Castle10K/KiCad_PCB/AI_chat/GPIO핀_리스트업.md

# GPIO 핀 정리

## Makerfabs esp32uwb dw3000보드 GPIO핀 정리

 * **강하게 피하기:**
  
   4, 6, 7, 8, 9, 10, 11, 16, 17, 18, 19, 23, 27, 34
 * **부팅문제 때문에 가급적 피하기:**
  
   2, 5, 12, 15

 * **입력으로만 사용:**
  
   34, 35, 36, 39

## 추천 핀

**13, 14, 21, 22, 25, 26, 32, 33**
