Castle10K/KiCad_PCB/AI_chat/PCB_제작_순서정리.md

# PCB 제작 순서

### 최초 PCB 제작해봄

---

ESP32에 연결되는 신호, 데이터선을 모두 정해놓은 다음 구리선 배치함.

배치하고 라우팅 하다보니 선이 너무 꼬여서 배치가 거의 불가능함.

신호 간섭과 EMI 등을 고려해 모듈들 배치를 완료한 다음 센서 등에서 최대한 짧게 메인MCU에 연결되는 방식이면 참 좋겠다는 생각이 들었다.

그래서 GPT랑 같이 정리한 결과를 아래 작성

---

### 제작 순서

1. ESP32에서 사용 금지/주의 핀 먼저 제외
2. 남은 안전한 GPIO에 임시 할당
3. ERC 검사
4. 풋프린트 할당
5. PCB로 업데이트
6. 부품 배치만 먼저 진행
7. RATSNEST 선이 꼬이는 부분 확인 -> 연결 지시선인 얇은 파란선 (가연결선 같이 생김)
8. 바꿔도 되는 GPIO/커넥터 핀맵 검토
9. 회로도 편집기로 돌아가 연결 수정
10. PCB 업데이트
11. 다시 배치 확인
12. 거의 확정되면 라우팅 시작

---

## 특히, 6번에서 바로 라우팅 하지 않는게 좋다

커넥터 핀 번호는 실제 꽂는 방향 기준으로 문서화 하는게 좋다.
