Castle10K/KiCad_PCB/UWB_ESP32S3_MainBoard_v2/UWB_ESP32S3_MainBoard_v2/UWB_ESP32S3_MainBoard_v2.kicad_pcb

## KiCad design UWB_ESP32S3_MainBoard_v2/UWB_ESP32S3_MainBoard_v2/UWB_ESP32S3_MainBoard_v2.kicad_pcb (2026-08-06)

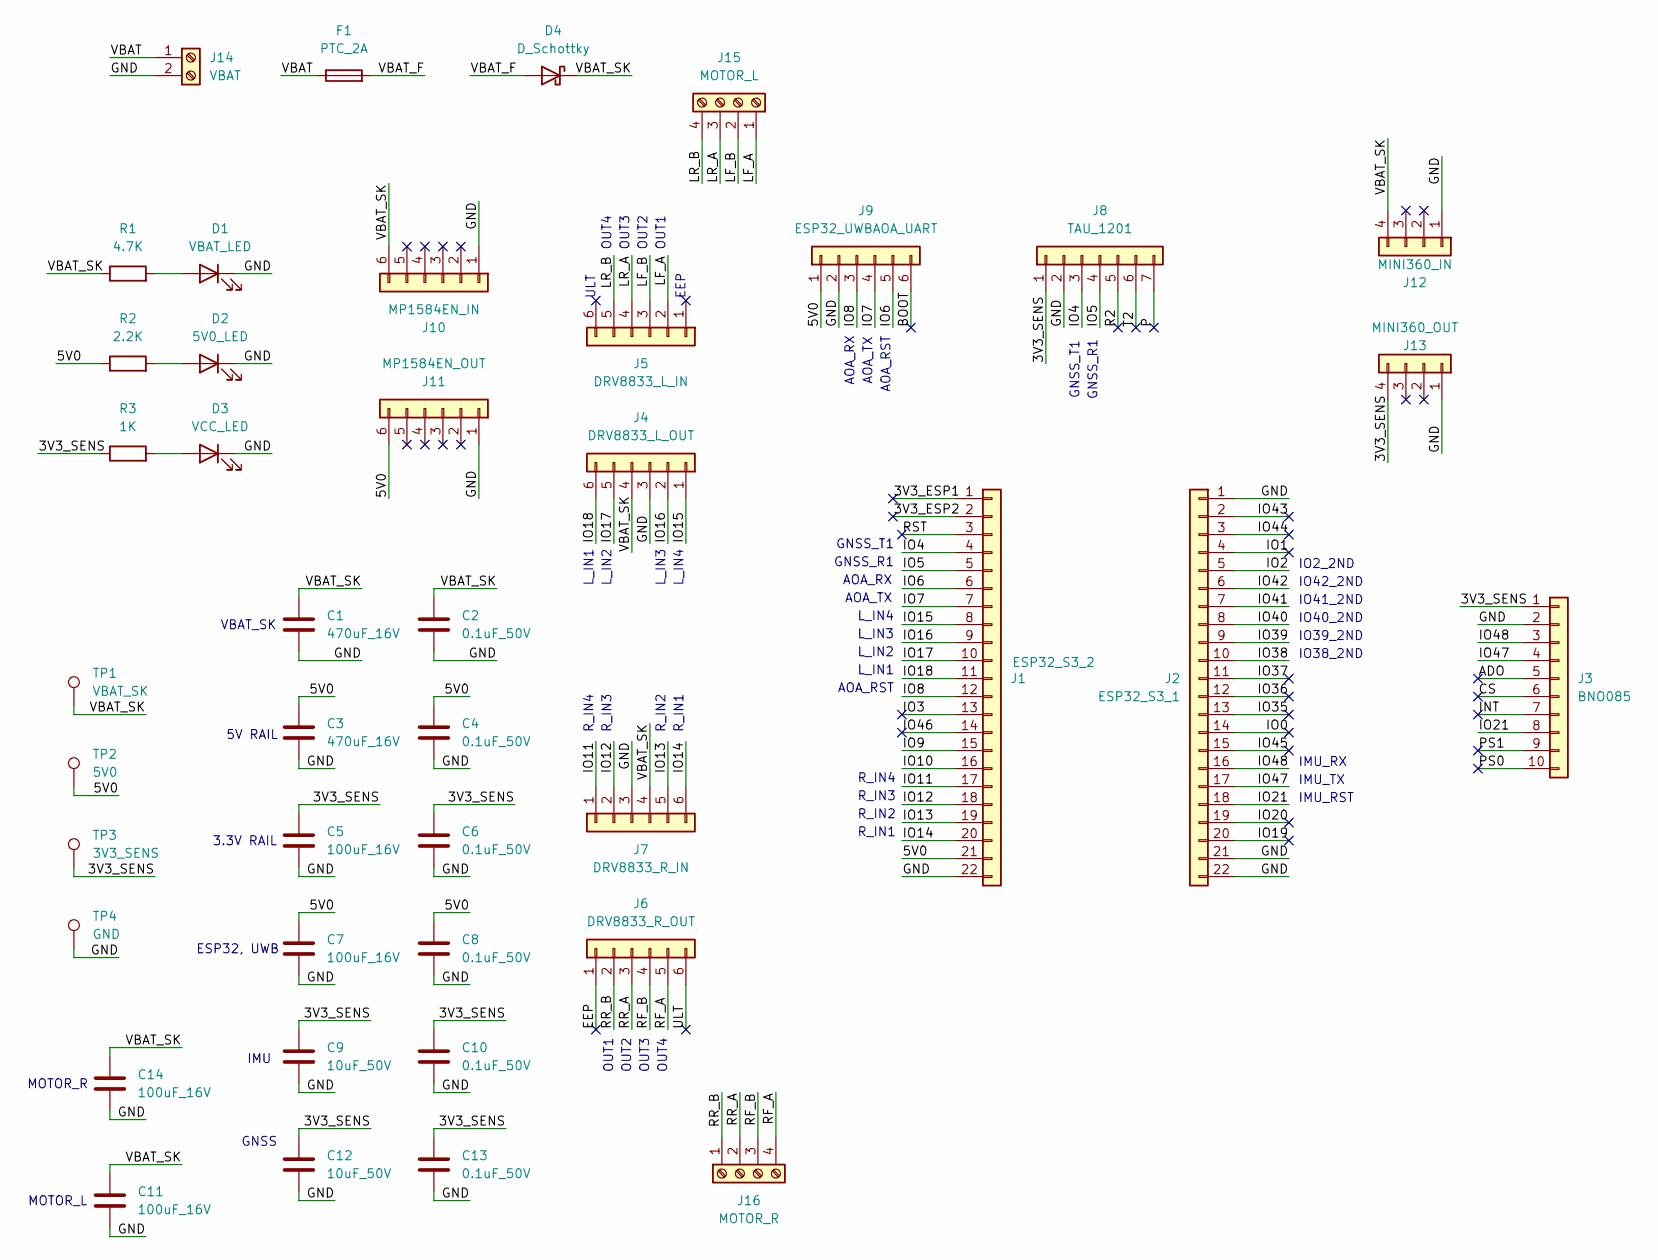
[picture p1: schematic UWB_ESP32S3_MainBoard_v2.kicad_sch]

Parts:
C1, C3: 470uF_16V; CP_Radial_D8.0mm_P3.50mm
C2, C4, C6, C8, C10, C13: 0.1uF_50V; C_0805_2012Metric_Pad1.18x1.45mm_HandSolder
C5, C7, C11, C14: 100uF_16V; CP_Radial_D5.0mm_P2.00mm
C9, C12: 10uF_50V; C_0805_2012Metric_Pad1.18x1.45mm_HandSolder
D1: VBAT_LED; LED_0805_2012Metric_Pad1.15x1.40mm_HandSolder
D2: 5V0_LED; LED_0805_2012Metric_Pad1.15x1.40mm_HandSolder
D3: VCC_LED; LED_0805_2012Metric_Pad1.15x1.40mm_HandSolder
D4: D_Schottky; D_SMA_Handsoldering
F1: PTC_2A; PTC_Radial_Disc_P5.08mm_Drill1.0mm
J1: ESP32_S3_2; PinSocket_1x22_P2.54mm_Vertical
J2: ESP32_S3_1; PinSocket_1x22_P2.54mm_Vertical
J3: BNO085; PinSocket_1x10_P2.54mm_Vertical
J4: DRV8833_L_OUT; PinSocket_1x06_P2.54mm_Vertical
J5: DRV8833_L_IN; PinSocket_1x06_P2.54mm_Vertical
J6: DRV8833_R_OUT; PinSocket_1x06_P2.54mm_Vertical
J7: DRV8833_R_IN; PinSocket_1x06_P2.54mm_Vertical
J8: TAU_1201; PinSocket_1x07_P2.54mm_Vertical
J9: ESP32_UWBAOA_UART; JST_XH_B6B-XH-A_1x06_P2.50mm_Vertical
J10: MP1584EN_IN; PinSocket_1x06_P2.54mm_Vertical
J11: MP1584EN_OUT; PinSocket_1x06_P2.54mm_Vertical
J12: MINI360_IN; PinSocket_1x04_P2.54mm_Vertical
J13: MINI360_OUT; PinSocket_1x04_P2.54mm_Vertical
J14: VBAT; KF301_2P_5.00mm
J15: MOTOR_L; KF301_4P_5.00mm
J16: MOTOR_R; KF301_4P_5.00mm
R1: 4.7K; R_0805_2012Metric_Pad1.20x1.40mm_HandSolder
R2: 2.2K; R_0805_2012Metric_Pad1.20x1.40mm_HandSolder
R3: 1K; R_0805_2012Metric_Pad1.20x1.40mm_HandSolder
TP1: VBAT_SK; TestPoint_Pad_D2.0mm
TP2: 5V0; TestPoint_Pad_D2.0mm
TP3: 3V3_SENS; TestPoint_Pad_D2.0mm
TP4: GND; TestPoint_Pad_D2.0mm

Connections:
/3V3_ESP1: J1.1
/3V3_ESP2: J1.2
/3V3_SENS: C5.1, C6.1, C9.1, C10.1, C12.1, C13.1, J3.1, J8.1, J13.4, R3.1, TP3.1 (1_1)
/5V0: C3.1, C4.1, C7.1, C8.1, J1.21, J9.1, J11.6, R2.1, TP2.1 (1_1)
/ADO: J3.5
/BOOT: J9.6
/CS: J3.6
/EEP: J6.1
/GND: C1.2, C2.2, C3.2, C4.2, C5.2, C6.2, C7.2, C8.2, C9.2, C10.2, C11.2, C12.2, C13.2, C14.2, D1.1 (K), D2.1 (K), D3.1 (K), J1.22, J2.1, J2.21, J2.22, J3.2, J4.3, J7.3, J8.2, J9.2, J10.1, J11.1, J12.1, J13.1, J14.2, TP4.1 (1_1)
/INT: J3.7
/IO0: J2.14
/IO1: J2.4
/IO2: J2.5
/IO3: J1.13
/IO4: J1.4, J8.3
/IO5: J1.5, J8.4
/IO6: J1.6, J9.5
/IO7: J1.7, J9.4
/IO8: J1.12, J9.3
/IO9: J1.15
/IO10: J1.16
/IO11: J1.17, J7.1
/IO12: J1.18, J7.2
/IO13: J1.19, J7.5
/IO14: J1.20, J7.6
/IO15: J1.8, J4.1
/IO16: J1.9, J4.2
/IO17: J1.10, J4.5
/IO18: J1.11, J4.6
/IO19: J2.20
/IO20: J2.19
/IO21: J2.18, J3.8
/IO35: J2.13
/IO36: J2.12
/IO37: J2.11
/IO38: J2.10
/IO39: J2.9
/IO40: J2.8
/IO41: J2.7
/IO42: J2.6
/IO43: J2.2
/IO44: J2.3
/IO45: J2.15
/IO46: J1.14
/IO47: J2.17, J3.4
/IO48: J2.16, J3.3
/LF_A: J5.2, J15.1
/LF_B: J5.3, J15.2
/LR_A: J5.4, J15.3
/LR_B: J5.5, J15.4
/P: J8.7
/PS0: J3.10
/PS1: J3.9
/R2: J8.5
/RF_A: J6.5, J16.4
/RF_B: J6.4, J16.3
/RR_A: J6.3, J16.2
/RR_B: J6.2, J16.1
/RST: J1.3
/T2: J8.6
/ULT: J6.6
/VBAT: F1.1, J14.1
/VBAT_F: D4.2 (A), F1.2
/VBAT_SK: C1.1, C2.1, C11.1, C14.1, D4.1 (K), J4.4, J7.4, J10.6, J12.4, R1.1, TP1.1 (1_1)
unnamed: D1.2 (A), R1.2
unnamed: D2.2 (A), R2.2
unnamed: D3.2 (A), R3.2

Notes on the sheet:
VBAT_SK
R_IN2
R_IN3
OUT4
L_IN4
R_IN4
EEP
OUT1
L_IN1
IMU
AOA_RST
GNSS_T1
IMU_TX
IO40_2ND
IMU_RST
AOA_TX
OUT2
GNSS_R1
IO2_2ND
L_IN3
L_IN2
R_IN1
IMU_RX
AOA_RX
IO39_2ND
IO41_2ND
IO42_2ND
IO38_2ND
MOTOR_L
OUT3
GNSS
ESP32, UWB
ULT
MOTOR_R
3.3V RAIL
5V RAIL

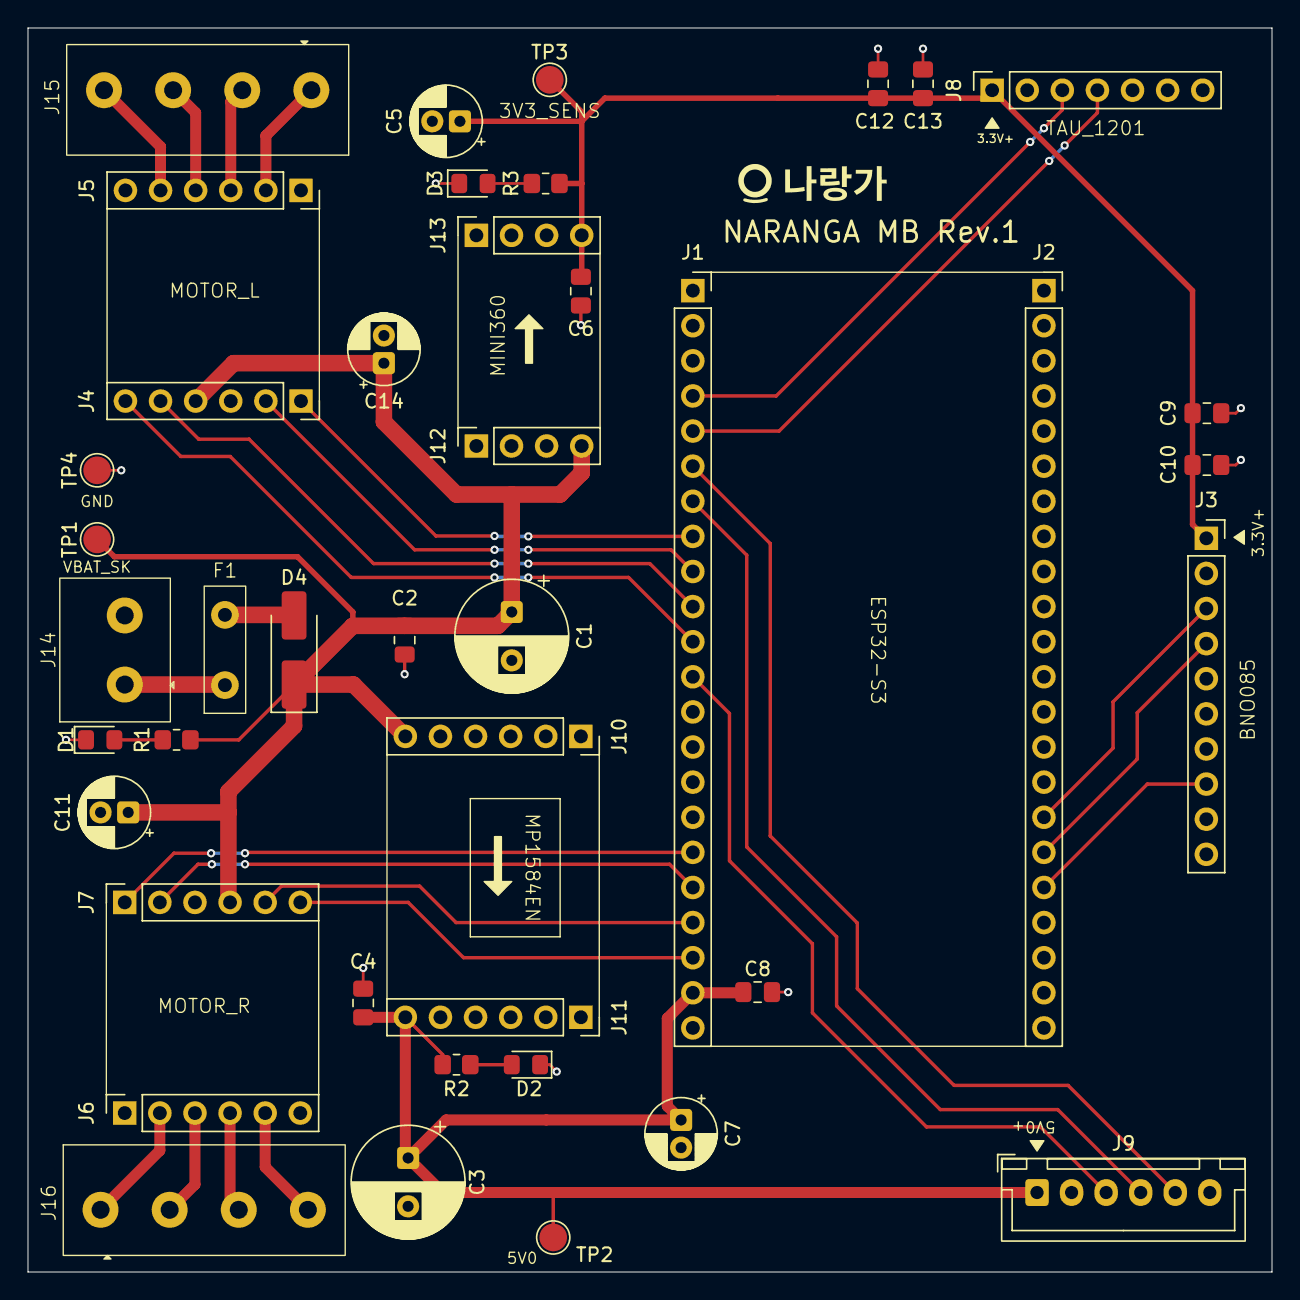
[picture p2: board UWB_ESP32S3_MainBoard_v2.kicad_pcb from above]

Board: 2 copper layers, 90.0 x 90.0 mm, 42 parts (0 on the bottom side), 33 nets.
