Castle10K/KiCad_PCB/PowerDistributionBoard/PDB/PDB.kicad_pcb

## KiCad design PowerDistributionBoard/PDB/PDB.kicad_pcb (2026-08-06)

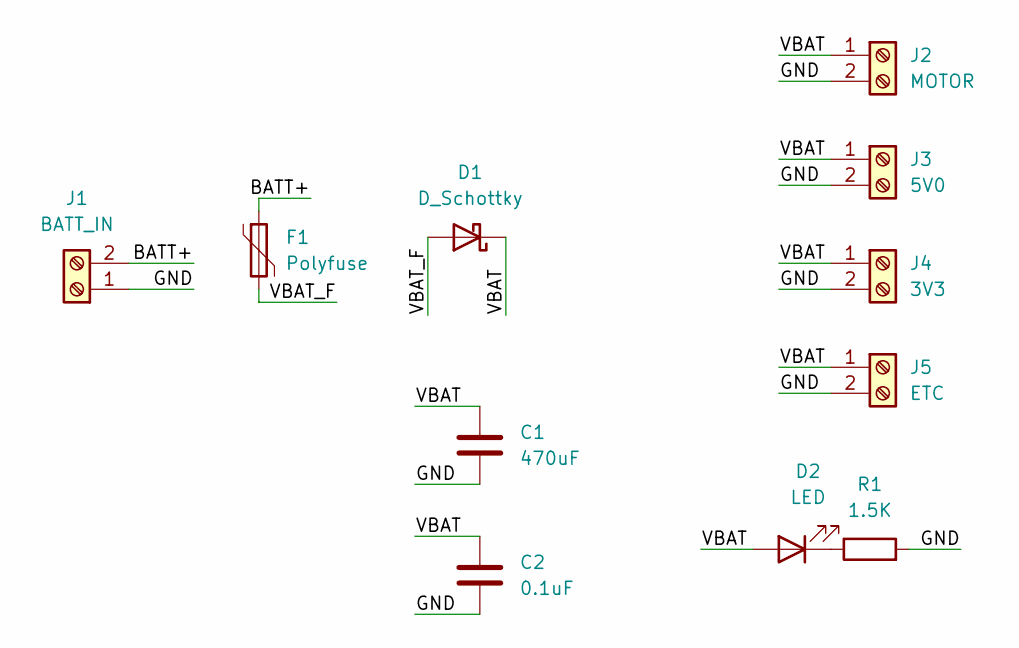
[picture p3: schematic PDB.kicad_sch]

Parts:
C1: 470uF; C_Radial_D8.0mm_H11.5mm_P3.50mm
C2: 0.1uF; C_0805_2012Metric_Pad1.18x1.45mm_HandSolder
D1: D_Schottky; D_SMA_Handsoldering
D2: LED; LED_0805_2012Metric_Pad1.15x1.40mm_HandSolder
F1: Polyfuse; PTC_Radial_Disc_P5.08mm_Drill1.0mm
J1: BATT_IN; KF301_2P_5.00mm
J2: MOTOR; KF301_2P_5.00mm
J3: 5V0; KF301_2P_5.00mm
J4: 3V3; KF301_2P_5.00mm
J5: ETC; KF301_2P_5.00mm
R1: 1.5K; R_0805_2012Metric_Pad1.20x1.40mm_HandSolder

Connections:
/BATT+: F1.1, J1.2
/GND: C1.2, C2.2, J1.1, J2.2, J3.2, J4.2, J5.2, R1.2
/VBAT: C1.1, C2.1, D1.1 (K), D2.2 (A), J2.1, J3.1, J4.1, J5.1
/VBAT_F: D1.2 (A), F1.2
unnamed: D2.1 (K), R1.1

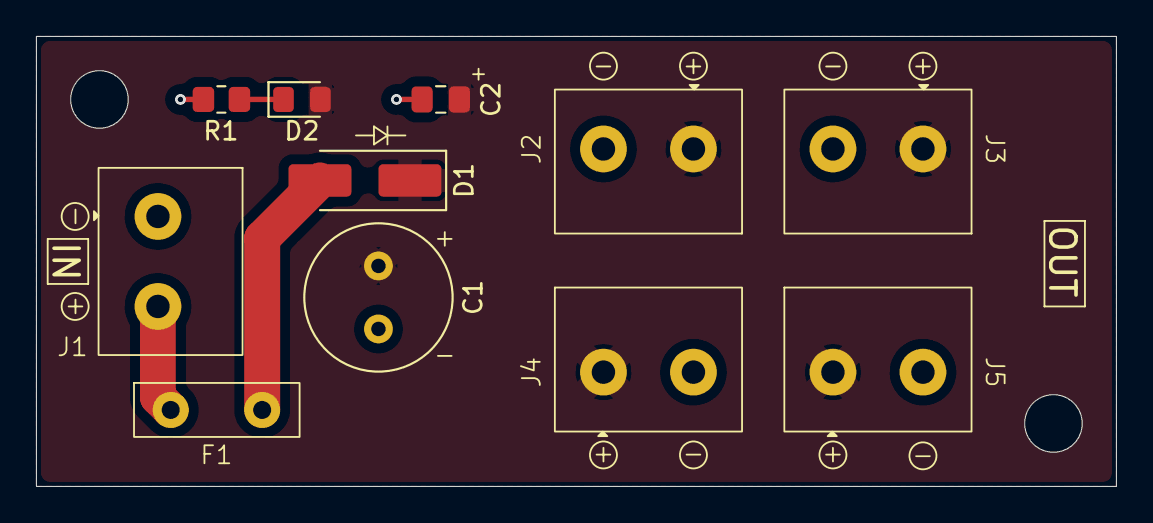
[picture p4: board PDB.kicad_pcb from above]

Board: 2 copper layers, 60.0 x 25.0 mm, 13 parts (0 on the bottom side), 5 nets.

Other parts of the board:
M3, M3#2: MountingHole_3.2mm_M3
