Castle10K/KiCad_PCB/MainBoard/MainBoard.kicad_pcb

## KiCad design MainBoard/MainBoard.kicad_pcb (2026-05-28)

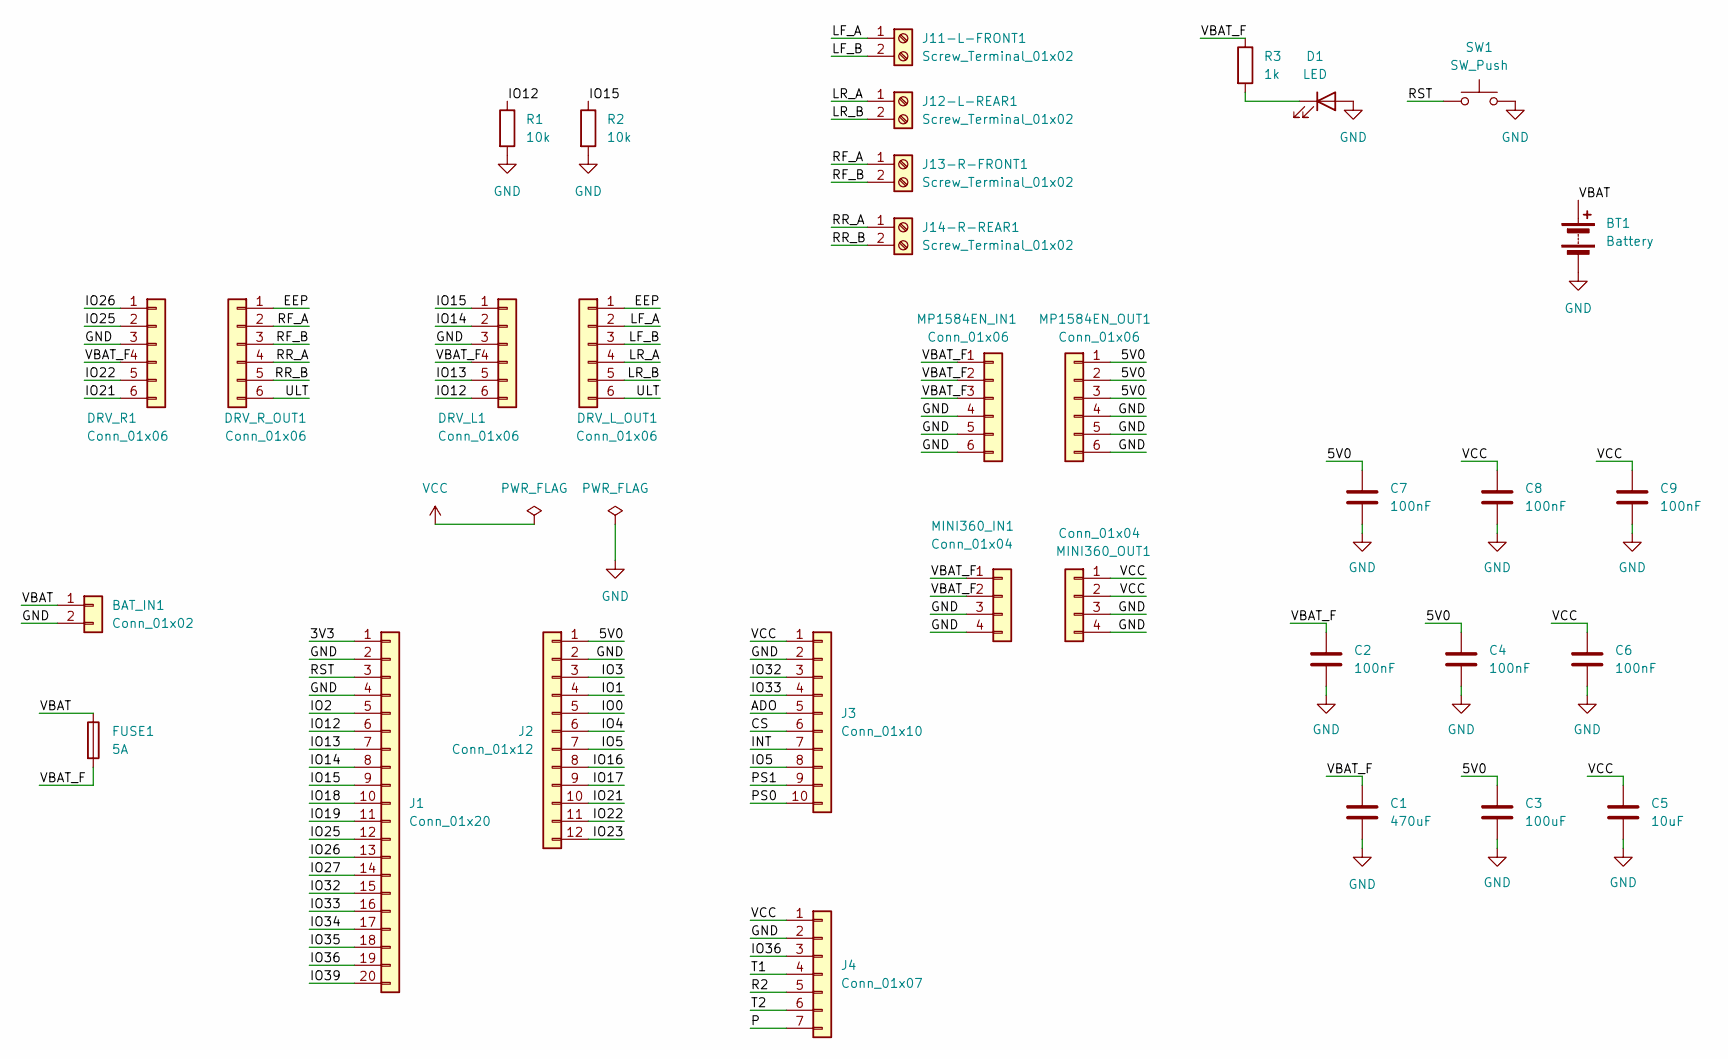
[picture p5: schematic MainBoard.kicad_sch]

Parts:
BAT_IN1: Conn_01x02; AMASS_XT30UPB-F_1x02_P5.0mm_Vertical
BT1: Battery
C1: 470uF; CP_Radial_D6.3mm_P2.50mm
C2, C4, C6, C7, C8, C9: 100nF; C_Disc_D5.0mm_W2.5mm_P5.00mm
C3: 100uF; CP_Radial_D6.3mm_P2.50mm
C5: 10uF; CP_Radial_D5.0mm_P2.50mm
D1: LED; LED_D5.0mm
DRV_L1: Conn_01x06; PinSocket_1x06_P2.54mm_Vertical
DRV_L_OUT1: Conn_01x06; PinSocket_1x06_P2.54mm_Vertical
DRV_R1: Conn_01x06; PinSocket_1x06_P2.54mm_Vertical
DRV_R_OUT1: Conn_01x06; PinSocket_1x06_P2.54mm_Vertical
FUSE1: 5A; Fuseholder_Cylinder-5x20mm_Schurter_0031_8201_Horizontal_Op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
J1: Conn_01x20; PinSocket_1x20_P2.54mm_Vertical
J2: Conn_01x12; PinSocket_1x12_P2.54mm_Vertical
J3: Conn_01x10; PinSocket_1x10_P2.54mm_Vertical
J4: Conn_01x07; PinSocket_1x07_P2.54mm_Vertical
J11-L-FRONT1, J12-L-REAR1, J13-R-FRONT1, J14-R-REAR1: Screw_Terminal_01x02; PhoenixContact_MSTBA_2,5_2-G-5,08_1x02_P5.08mm_Horizontal
MINI360_IN1, MINI360_OUT1: Conn_01x04; PinSocket_1x04_P2.54mm_Vertical
MP1584EN_IN1, MP1584EN_OUT1: Conn_01x06; PinSocket_1x06_P2.54mm_Vertical
R1, R2: 10k; R_Axial_DIN0204_L3.6mm_D1.6mm_P7.62mm_Horizontal
R3: 1k; R_Axial_DIN0204_L3.6mm_D1.6mm_P7.62mm_Horizontal
SW1: SW_Push; SW_PUSH_6mm

Connections:
/3V3: J1.1
/5V0: C3.1, C4.1, C7.1, J2.1, MP1584EN_OUT1.1, MP1584EN_OUT1.2, MP1584EN_OUT1.3
/ADO: J3.5
/CS: J3.6
/EEP: DRV_L_OUT1.1, DRV_R_OUT1.1
/INT: J3.7
/IO0: J2.5
/IO1: J2.4
/IO2: J1.5
/IO3: J2.3
/IO4: J2.6
/IO5: J2.7, J3.8
/IO12: DRV_L1.6, J1.6, R1.1
/IO13: DRV_L1.5, J1.7
/IO14: DRV_L1.2, J1.8
/IO15: DRV_L1.1, J1.9, R2.1
/IO16: J2.8
/IO17: J2.9
/IO18: J1.10
/IO19: J1.11
/IO21: DRV_R1.6, J2.10
/IO22: DRV_R1.5, J2.11
/IO23: J2.12
/IO25: DRV_R1.2, J1.12
/IO26: DRV_R1.1, J1.13
/IO27: J1.14
/IO32: J1.15, J3.3
/IO33: J1.16, J3.4
/IO34: J1.17
/IO35: J1.18
/IO36: J1.19, J4.3
/IO39: J1.20
/LF_A: DRV_L_OUT1.2, J11-L-FRONT1.1
/LF_B: DRV_L_OUT1.3, J11-L-FRONT1.2
/LR_A: DRV_L_OUT1.4, J12-L-REAR1.1
/LR_B: DRV_L_OUT1.5, J12-L-REAR1.2
/P: J4.7
/PS0: J3.10
/PS1: J3.9
/R2: J4.5
/RF_A: DRV_R_OUT1.2, J13-R-FRONT1.1
/RF_B: DRV_R_OUT1.3, J13-R-FRONT1.2
/RR_A: DRV_R_OUT1.4, J14-R-REAR1.1
/RR_B: DRV_R_OUT1.5, J14-R-REAR1.2
/RST: J1.3, SW1.1
/T1: J4.4
/T2: J4.6
/ULT: DRV_L_OUT1.6, DRV_R_OUT1.6
/VBAT: BAT_IN1.1, BT1.1 (+), FUSE1.1
/VBAT_F: C1.1, C2.1, DRV_L1.4, DRV_R1.4, FUSE1.2, MINI360_IN1.1, MINI360_IN1.2, MP1584EN_IN1.1, MP1584EN_IN1.2, MP1584EN_IN1.3, R3.1
GND: BAT_IN1.2, BT1.2 (-), C1.2, C2.2, C3.2, C4.2, C5.2, C6.2, C7.2, C8.2, C9.2, D1.2 (A), DRV_L1.3, DRV_R1.3, J1.2, J1.4, J2.2, J3.2, J4.2, MINI360_IN1.3, MINI360_IN1.4, MINI360_OUT1.3, MINI360_OUT1.4, MP1584EN_IN1.4, MP1584EN_IN1.5, MP1584EN_IN1.6, MP1584EN_OUT1.4, MP1584EN_OUT1.5, MP1584EN_OUT1.6, R1.2, R2.2, SW1.2
unnamed: D1.1 (K), R3.2
VCC: C5.1, C6.1, C8.1, C9.1, J3.1, J4.1, MINI360_OUT1.1, MINI360_OUT1.2

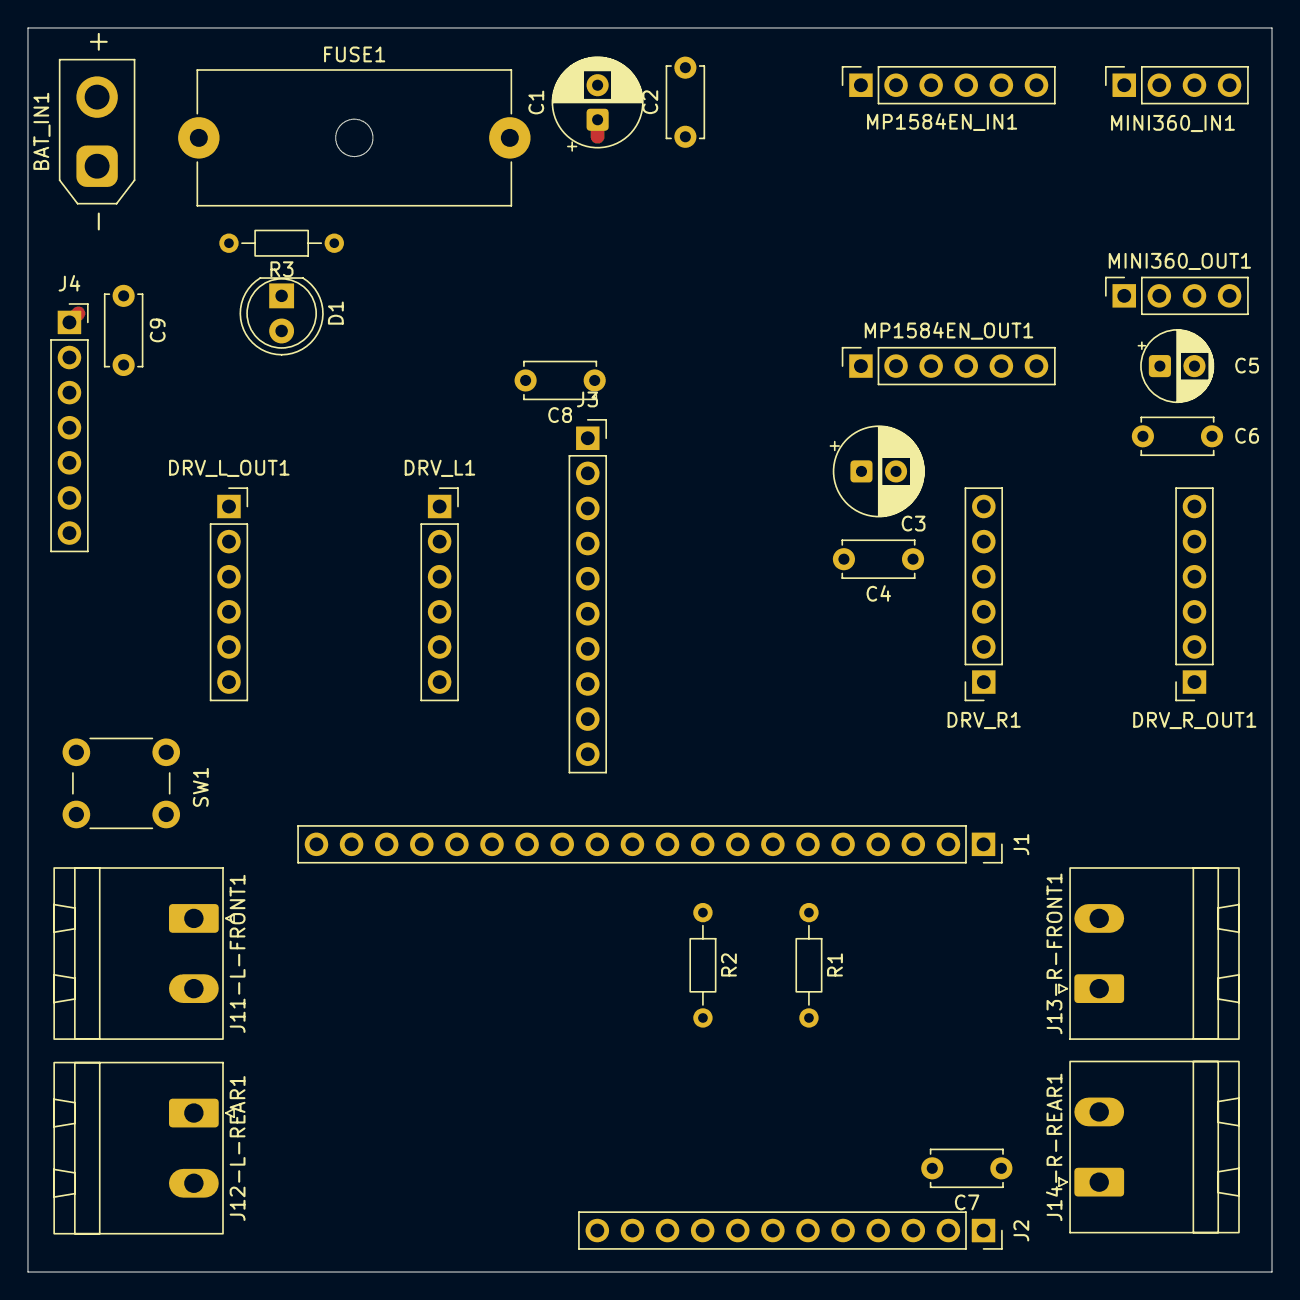
[picture p6: board MainBoard.kicad_pcb from above]

Board: 2 copper layers, 90.0 x 90.0 mm, 32 parts (0 on the bottom side), 29 nets.
