Castle10K/KiCad_PCB/(commit log)

2026-05-08 KiCad esp32 12번핀에 저항 추가 전
    [MainBoard.kicad_pcb, MainBoard.kicad_sch]
2026-05-08 회로도 -> 풋프린트 완료 PCB편집기 제작 시작
    [MainBoard.kicad_pcb, MainBoard.kicad_sch]
2026-05-11 mini360_mp1584en회로수정
    [MainBoard.kicad_pcb, MainBoard.kicad_sch]
2026-05-14 전원배선완료
    [MainBoard.kicad_pcb, MainBoard.kicad_sch]
2026-05-14 drv8833_R배선필요
    [MainBoard.kicad_pcb, MainBoard.kicad_sch]
2026-05-21 PCB상 핀 배치가 짧고 편한 라우팅을 위해 핀맵 재설정 필요
    [MainBoard.kicad_pcb]
2026-05-26 배선 삭제, 재배치 필요. 핀 넘버 정리
    [MainBoard.kicad_pcb]
2026-05-28 ESP32_S3 칩 추가 분화
    [UWB_ESP32S3_MainBoard_v2.kicad_pcb, UWB_ESP32S3_MainBoard_v2.kicad_sch]
2026-05-29 PCB재설계
    [UWB_ESP32S3_MainBoard_v2.kicad_sch]
2026-06-02 esp32-s3 기반 pcb 배치 시작
    [UWB_ESP32S3_MainBoard_v2.kicad_pcb, UWB_ESP32S3_MainBoard_v2.kicad_sch]
2026-06-08 배치중1
    [UWB_ESP32S3_MainBoard_v2.kicad_pcb]
2026-06-09 배치 완료, 풋프린트 추가 등
    [UWB_ESP32S3_MainBoard_v2.kicad_pcb, UWB_ESP32S3_MainBoard_v2.kicad_sch]
